tmssngr/z8verilog/readme.md

# Z8 Softcore

The project is about implementing a Zilog Z8 microcontroller in Verilog.

So far it can run the [Tiny computer](https://hc-ddr.hucki.net/wiki/doku.php/tiny) which generates the TV-video output using a timer interrupt:

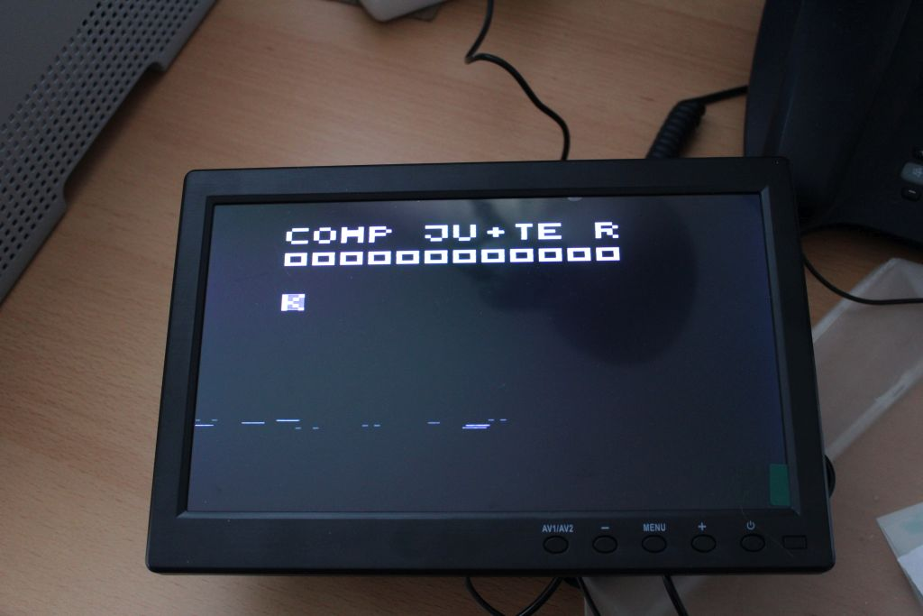
[picture p1: images/IMG_2479s.jpg]
2k Ju+Te-Computer


and its 320x192 pixels extension (here only one 8kB video RAM for monochrome output) with separate video processor:

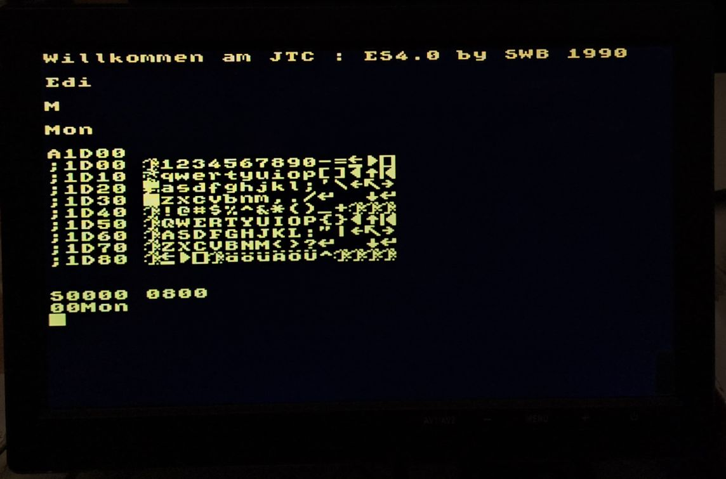
[picture p2: images/jtc6k-es40-hdmi.jpg]
6k ES4.0


on a Tang Tano 9k:
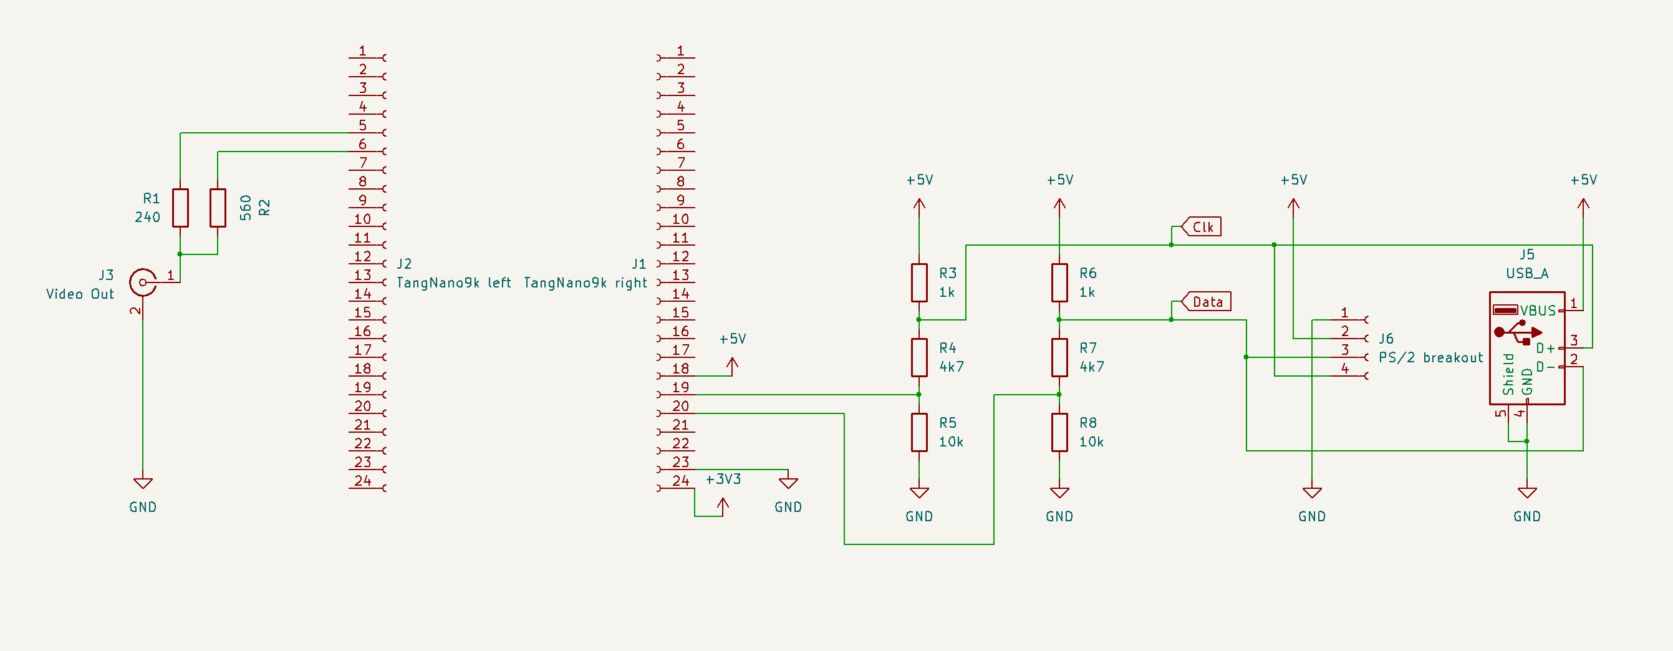
[picture p3: images/schematic-ju+te.png]
Tang Nano 9k


## Notes for Gowin-IDE 1.9.11.03 Education
- in *Project | Configuration*, page *Synthesize* set *Verilog Language* to **System Verilog 2017**
- use right most toolbar buttons to *Synthesize*, *Run Place and Route*, or *Run All*
- Programmer:
  - in *Cable Setting* dialog change *Port* from *USB Debugger A/0/386/null* to **USB Debugger A/1/385/null**
  - *SRAM Program* -> temporary
  - *Embedded Flash Mode* -> permanently

## State of the Z8 Softcore

- [x] implement all operations
  - [x] `nop`
  - [x] carry-flag manipulation operations
  - [x] `srp #IM`
  - [x] single-register ALU operations
    - [x] `xxx R`
    - [x] `xxx IR`
    - [x] `inc r`
  - [x] dual-register ALU operations
    - [x] `xxx r, r`
    - [x] `xxx r, Ir`
    - [x] `xxx R, R`
    - [x] `xxx R, IR`
    - [x] `xxx R, #IM`
    - [x] `xxx IR, #IM`
  - [x] load operations
    - [x] `ld r, #IM`
    - [x] `ld r, R`
    - [x] `ld R, r`
    - [x] `ld r, Ir`
    - [x] `ld Ir, r`
    - [x] `ld R, R`
    - [x] `ld R, IR`
    - [x] `ld IR, R`
    - [x] `ld R, #IM`
    - [x] `ld IR, #IM`
    - [x] `ld r, r(x)`
    - [x] `ld r(x), r`
  - [x] control flow operations
    - [x] `djnz r, RA`
    - [x] `jr cc, RA`
    - [x] `jp cc, DA`
    - [x] `jp IRR`
  - [x] `di`, `ei` (disable/enable interrupt)
  - [x] memory operations
    - [x] `ldc r, Irr`
    - [x] `ldc Irr, r`
    - [x] `ldci Ir, Irr`
    - [x] `ldci Irr, Ir`
    - [x] let `lde`/`ldei` work the same as `ldc`/`ldci`
  - [x] stack operations
    - [x] internal stack
      - [x] `pop R`
      - [x] `pop IR`
      - [x] `push R`
      - [x] `push IR`
      - [x] `call IRR`
      - [x] `call DA`
      - [x] `ret`
      - [x] `iret`
    - [x] external stack
  - [x] illegal instruction handling (stop at that address)
- [ ] port 2
  - [ ] input
  - [x] output
- [ ] port 3
  - [ ] P30-P33 generic input
  - [x] P34-P37 generic output
  - [ ] special counter/serial input/output
- [ ] Timers/Counters
  - [x] basics
  - [ ] special external modes
  - [ ] UART
    - [x] basics
    - [ ] parity handling
- [ ] interrupt handling
  - [x] basics (launching the right interrupt)
  - [ ] handle priorities
