tmssngr/z8verilog/images/jtc-6k.jpg

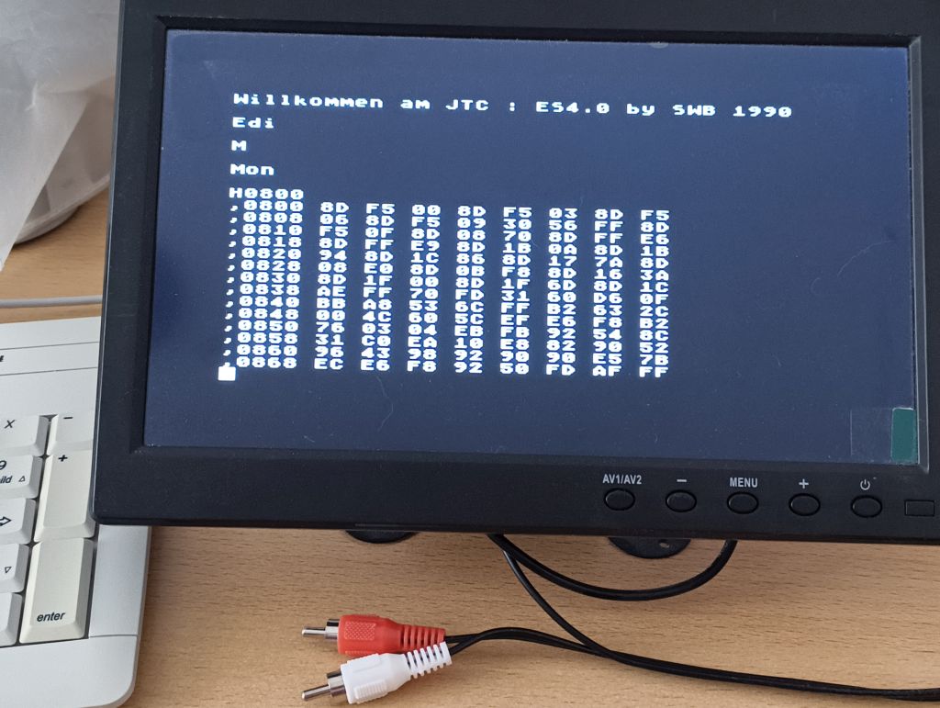
images/jtc-6k.jpg
