tmssngr/z8verilog/images/tang-nano-9k-ju+te.jpg

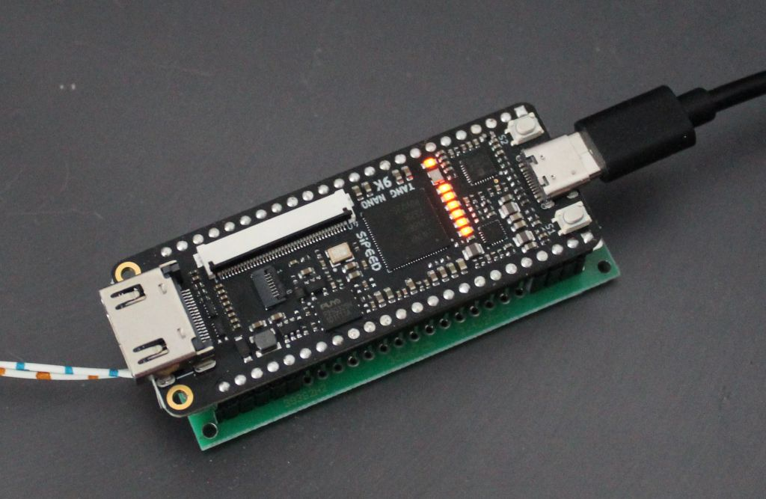
images/tang-nano-9k-ju+te.jpg
