tmssngr/z8verilog/src/Ps2Decoder.v

`include "Ps2Rx.v"
`include "SerialTxDbg.v"

`default_nettype none

// see https://wiki.osdev.org/PS/2_Keyboard
module Ps2Decoder #(
    parameter counterBits = 8,
    parameter minClk = 15,
    parameter maxClk = 25,
    parameter readAt = 5
)
(
    input wire       clk,
    input wire       clkEnable,
    input wire       ps2Clk,
    input wire       ps2Data,
    input wire       reset,
    input wire[3:0]  address,
    output wire[7:0] keybits,
    output wire      error,
    output reg       softReset,
    output wire      debugShift,
    output wire      debugCtrl,
    output wire      debugAlt,
    output wire      debugE0,
    output wire      debugF0
);
    wire [7:0] data;
    wire       dataReady;
    reg        prevDataReady = 0;
    reg        receivedE0 = 0;
    reg        receivedF0 = 0;
    reg [3:0]  column = 0;
    reg [3:0]  columnMask = 0;
    reg [8:0]  activeKey = 0; // {E0 prefix, scan code} of the active ordinary key

    reg  shiftLeft = 0;
    reg  shiftRight = 0;
    reg  ctrlLeft = 0;
    reg  ctrlRight = 0;
    reg  altLeft = 0;
    reg  altRight = 0;
    wire shift = shiftLeft | shiftRight;
    wire ctrl = ctrlLeft | ctrlRight;
    wire alt = altLeft | altRight;

    Ps2Rx #(
        .counterBits(counterBits),
        .minClk(minClk),
        .maxClk(maxClk),
        .readAt(readAt)
    ) rx(
        .clk(clk),
        .clkEnable(clkEnable),
        .ps2Clk(ps2Clk),
        .ps2Data(ps2Data),
        .reset(reset),
        .data(data),
        .dataReady(dataReady),
        .error(error)
    );

    task setColumn;
        input [3:0] col;
        input [1:0] row;
        begin
            column <= col;
            columnMask <= 1 << row;
            activeKey <= {receivedE0, data};
        end
    endtask

    always @(posedge clk) begin
        if (clkEnable) begin
            if (reset) begin
                receivedE0 <= 0;
                receivedF0 <= 0;
                prevDataReady <= 0;
                column <= 0;
                columnMask <= 0;
                activeKey <= 0;
                shiftLeft <= 0;
                shiftRight <= 0;
                ctrlLeft <= 0;
                ctrlRight <= 0;
                altLeft <= 0;
                altRight <= 0;
                softReset <= 0;
            end
            else begin
                if (dataReady != prevDataReady) begin
                    prevDataReady <= dataReady;

                    if (dataReady) begin
                        if (data == 8'hE0) begin
                            receivedE0 <= 1;
                        end
                        else if (data == 8'hF0) begin
                            receivedF0 <= 1;
                        end
                        else begin
                            receivedE0 <= 0;
                            receivedF0 <= 0;
                            case (data)
                            8'h11: begin
                                if (receivedE0) altRight <= ~receivedF0;
                                else            altLeft <= ~receivedF0;
                            end
                            // Extended Shift codes are synthetic, e.g. Print Screen.
                            8'h12: if (~receivedE0) shiftLeft <= ~receivedF0;
                            8'h14: begin
                                if (receivedE0) ctrlRight <= ~receivedF0;
                                else            ctrlLeft <= ~receivedF0;
                            end
                            8'h59: if (~receivedE0) shiftRight <= ~receivedF0;
                            default: begin
                                if (receivedF0) begin
                                    if (activeKey == {receivedE0, data}) begin
                                        column <= 0;
                                        columnMask <= 0;
                                        activeKey <= 0;
                                    end
                                    softReset <= 0;
                                end
                                else if (receivedE0) begin
                                    case (data)
                                    //8'h69: // End
                                    8'h6B: setColumn(4'hD, 2'h2); // cursor left
                                    //8'h6C: // Home
                                    //8'h70: // Ins
                                    8'h71: begin // Del
                                        if (ctrl & alt & ~shift)
                                            softReset <= 1;
                                    end
                                    8'h72: setColumn(4'hE, 2'h0); // cursor down
                                    8'h74: setColumn(4'hF, 2'h1); // cursor right
                                    8'h75: setColumn(4'hE, 2'h2); // cursor up
                                    //8'h7A: // page down
                                    //8'h7D: // page up
                                    endcase
                                end
                                else begin
                                    case (data)
                                    8'h0D: setColumn(4'h1, 2'h2); // tab (left/right)
                                    8'h0E: setColumn(4'h1, 2'h3); // ` (up/down)
                                    8'h15: setColumn(4'h2, 2'h2); // Q
                                    8'h16: setColumn(4'h2, 2'h3); // 1
                                    8'h1A: setColumn(4'h2, 2'h0); // Y
                                    8'h1B: setColumn(4'h3, 2'h1); // S
                                    8'h1C: setColumn(4'h2, 2'h1); // A
                                    8'h1D: setColumn(4'h3, 2'h2); // W
                                    8'h1E: setColumn(4'h3, 2'h3); // 2
                                    8'h21: setColumn(4'h4, 2'h0); // C
                                    8'h22: setColumn(4'h3, 2'h0); // X
                                    8'h23: setColumn(4'h4, 2'h1); // D
                                    8'h24: setColumn(4'h4, 2'h2); // E
                                    8'h25: setColumn(4'h5, 2'h3); // 4
                                    8'h26: setColumn(4'h4, 2'h3); // 3
                                    8'h29: setColumn(4'h1, 2'h0); // Space
                                    8'h2A: setColumn(4'h5, 2'h0); // V
                                    8'h2B: setColumn(4'h5, 2'h1); // F
                                    8'h2C: setColumn(4'h6, 2'h2); // T
                                    8'h2D: setColumn(4'h5, 2'h2); // R
                                    8'h2E: setColumn(4'h6, 2'h3); // 5
                                    8'h31: setColumn(4'h7, 2'h0); // N
                                    8'h32: setColumn(4'h6, 2'h0); // B
                                    8'h33: setColumn(4'h7, 2'h1); // H
                                    8'h34: setColumn(4'h6, 2'h1); // G
                                    8'h35: setColumn(4'h7, 2'h2); // Z
                                    8'h36: setColumn(4'h7, 2'h3); // 6
                                    8'h3A: setColumn(4'h8, 2'h0); // M
                                    8'h3B: setColumn(4'h8, 2'h1); // J
                                    8'h3C: setColumn(4'h8, 2'h2); // U
                                    8'h3D: setColumn(4'h8, 2'h3); // 7
                                    8'h3E: setColumn(4'h9, 2'h3); // 8
                                    8'h41: setColumn(4'h9, 2'h0); // ,
                                    8'h42: setColumn(4'h9, 2'h1); // K
                                    8'h43: setColumn(4'h9, 2'h2); // I
                                    8'h44: setColumn(4'hA, 2'h2); // O
                                    8'h45: setColumn(4'hB, 2'h3); // 0
                                    8'h46: setColumn(4'hA, 2'h3); // 9
                                    8'h49: setColumn(4'hA, 2'h0); // .
                                    8'h4A: setColumn(4'hB, 2'h0); // /
                                    8'h4B: setColumn(4'hA, 2'h1); // L
                                    8'h4C: setColumn(4'hB, 2'h1); // ; (ö*)
                                    8'h4D: setColumn(4'hB, 2'h2); // P
                                    //8'h4E: // -
                                    8'h52: setColumn(4'hC, 2'h1); // ' (ä-)
                                    8'h54: setColumn(4'hC, 2'h2); // [ (ü+)
                                    8'h55: setColumn(4'hC, 2'h2); // =
                                    8'h5A: setColumn(4'hC, 2'h0); // Enter
                                    8'h5B: setColumn(4'hC, 2'h2); // ]
                                    8'h5D: setColumn(4'hC, 2'h1); // \
                                    8'h66: setColumn(4'hC, 2'h3); // backspace

                                    8'h76: setColumn(4'h1, 2'h3); // ESC
                                    endcase
                                end
                            end
                            endcase
                        end
                    end
                end
            end
        end
    end

    assign keybits = (column == address ? {columnMask, 4'b0} : 0)
                   | (shift & (address == 1) ? 8'h20 : 0);
    assign debugShift = shift;
    assign debugCtrl = ctrl;
    assign debugAlt = alt;
    assign debugE0 = receivedE0;
    assign debugF0 = receivedF0;
endmodule

module Ps2DecoderMulti #(
    parameter counterBits = 8,
    parameter minClk = 15,
    parameter maxClk = 25,
    parameter readAt = 5
)
(
    input wire       clk,
    input wire       clkEnable,
    input wire       ps2Clk,
    input wire       ps2Data,
    input wire       reset,
    input wire[3:0]  address,
    output wire[7:0] keybits,
    output wire      error,
    output reg       softReset,
    output wire      debugShift,
    output wire      debugCtrl,
    output wire      debugAlt,
    output wire      debugE0,
    output wire      debugF0
);
    wire [7:0] data;
    wire       dataReady;
    reg        prevDataReady = 0;
    reg        receivedE0 = 0;
    reg        receivedF0 = 0;
    reg [3:0]  column = 0;
    reg [3:0]  columnMask = 0;
    reg [8:0]  activeKey = 0; // {E0 prefix, scan code} of the active ordinary key

    reg  shiftLeft = 0;
    reg  shiftRight = 0;
    reg  ctrlLeft = 0;
    reg  ctrlRight = 0;
    reg  altLeft = 0;
    reg  altRight = 0;
    wire shift = shiftLeft | shiftRight;
    wire ctrl = ctrlLeft | ctrlRight;
    wire alt = altLeft | altRight;

    Ps2Rx #(
        .counterBits(counterBits),
        .minClk(minClk),
        .maxClk(maxClk),
        .readAt(readAt)
    ) rx(
        .clk(clk),
        .clkEnable(clkEnable),
        .ps2Clk(ps2Clk),
        .ps2Data(ps2Data),
        .reset(reset),
        .data(data),
        .dataReady(dataReady),
        .error(error)
    );

    task setColumn;
        input [3:0] col;
        input [1:0] row;
        begin
            column <= col;
            columnMask <= 1 << row;
            activeKey <= {receivedE0, data};
        end
    endtask

    always @(posedge clk) begin
        if (clkEnable) begin
            if (reset) begin
                receivedE0 <= 0;
                receivedF0 <= 0;
                prevDataReady <= 0;
                column <= 0;
                columnMask <= 0;
                activeKey <= 0;
                shiftLeft <= 0;
                shiftRight <= 0;
                ctrlLeft <= 0;
                ctrlRight <= 0;
                altLeft <= 0;
                altRight <= 0;
                softReset <= 0;
            end
            else begin
                if (dataReady != prevDataReady) begin
                    prevDataReady <= dataReady;

                    if (dataReady) begin
                        if (data == 8'hE0) begin
                            receivedE0 <= 1;
                        end
                        else if (data == 8'hF0) begin
                            receivedF0 <= 1;
                        end
                        else begin
                            receivedE0 <= 0;
                            receivedF0 <= 0;
                            case (data)
                            8'h11: begin
                                if (receivedE0) altRight <= ~receivedF0;
                                else            altLeft <= ~receivedF0;
                            end
                            // Extended Shift codes are synthetic, e.g. Print Screen.
                            8'h12: if (~receivedE0) shiftLeft <= ~receivedF0;
                            8'h14: begin
                                if (receivedE0) ctrlRight <= ~receivedF0;
                                else            ctrlLeft <= ~receivedF0;
                            end
                            8'h59: if (~receivedE0) shiftRight <= ~receivedF0;
                            /*
                              | 0 | 1 | 2 | 3 | 4 | 5 | 6 | 7 | 8 | 9 | A | B | C | D | E | F |
                            --+---+---+---+---+---+---+---+---+---+---+---+---+---+---+---+---+
                             3|   | 1 | 2 | 3 | 4 | 5 | 6 | 7 | 8 | 9 | 0 | < | > |BSp|Ins|CLS|
                            --+---+---+---+---+---+---+---+---+---+---+---+---+---+---+---+---+
                             2|Alt| Q | W | E | R | T | Z | U | I | O | P | - | = |Del| Up|Hom|
                            --+---+---+---+---+---+---+---+---+---+---+---+---+---+---+---+---+
                             1|Ctr| A | S | D | F | G | H | J | K | L | ; | + | * |Lft|LTp|Rgt|
                            --+---+---+---+---+---+---+---+---+---+---+---+---+---+---+---+---+
                             0|Shf| Y | X | C | V | B | N | M | , | . | / |Ret|Spc|Spc|Dwn|Ret|
                            --+---+---+---+---+---+---+---+---+---+---+---+---+---+---+---+---+
                            */
                            default: begin
                                if (receivedF0) begin
                                    if (activeKey == {receivedE0, data}) begin
                                        column <= 0;
                                        columnMask <= 0;
                                        activeKey <= 0;
                                    end
                                    softReset <= 0;
                                end
                                else if (receivedE0) begin
                                    case (data)
                                    //8'h69: // End
                                    8'h6B: setColumn(4'hD, 2'h1); // cursor left
                                    8'h6C: setColumn(4'hF, 2'h2); // Home
                                    8'h70: setColumn(4'hE, 2'h3); // Ins
                                    8'h71: begin // Del
                                        if (ctrl & alt & ~shift)
                                            softReset <= 1;
                                        else
                                            setColumn(4'hD, 2'h2); 
                                    end
                                    8'h72: setColumn(4'hE, 2'h0); // cursor down
                                    8'h74: setColumn(4'hF, 2'h1); // cursor right
                                    8'h75: setColumn(4'hE, 2'h2); // cursor up
                                    //8'h7A: // page down
                                    8'h7D: setColumn(4'hE, 2'h1); // page up (top-left)
                                    endcase
                                end
                                else begin
                                    case (data)
                                    //8'h0D: // tab
                                    //8'h0E: // `
                                    8'h15: setColumn(4'h1, 2'h2); // Q
                                    8'h16: setColumn(4'h1, 2'h3); // 1
                                    8'h1A: setColumn(4'h1, 2'h0); // Y
                                    8'h1B: setColumn(4'h2, 2'h1); // S
                                    8'h1C: setColumn(4'h1, 2'h1); // A
                                    8'h1D: setColumn(4'h2, 2'h2); // W
                                    8'h1E: setColumn(4'h2, 2'h3); // 2
                                    8'h21: setColumn(4'h3, 2'h0); // C
                                    8'h22: setColumn(4'h2, 2'h0); // X
                                    8'h23: setColumn(4'h3, 2'h1); // D
                                    8'h24: setColumn(4'h3, 2'h2); // E
                                    8'h25: setColumn(4'h4, 2'h3); // 4
                                    8'h26: setColumn(4'h3, 2'h3); // 3
                                    8'h29: setColumn(4'hC, 2'h0); // Space
                                    8'h2A: setColumn(4'h4, 2'h0); // V
                                    8'h2B: setColumn(4'h4, 2'h1); // F
                                    8'h2C: setColumn(4'h5, 2'h2); // T
                                    8'h2D: setColumn(4'h4, 2'h2); // R
                                    8'h2E: setColumn(4'h5, 2'h3); // 5
                                    8'h31: setColumn(4'h6, 2'h0); // N
                                    8'h32: setColumn(4'h5, 2'h0); // B
                                    8'h33: setColumn(4'h6, 2'h1); // H
                                    8'h34: setColumn(4'h5, 2'h1); // G
                                    8'h35: setColumn(4'h6, 2'h2); // Z
                                    8'h36: setColumn(4'h6, 2'h3); // 6
                                    8'h3A: setColumn(4'h7, 2'h0); // M
                                    8'h3B: setColumn(4'h7, 2'h1); // J
                                    8'h3C: setColumn(4'h7, 2'h2); // U
                                    8'h3D: setColumn(4'h7, 2'h3); // 7
                                    8'h3E: setColumn(4'h8, 2'h3); // 8
                                    8'h41: setColumn(4'h8, 2'h0); // ,
                                    8'h42: setColumn(4'h8, 2'h1); // K
                                    8'h43: setColumn(4'h8, 2'h2); // I
                                    8'h44: setColumn(4'h9, 2'h2); // O
                                    8'h45: setColumn(4'hA, 2'h3); // 0
                                    8'h46: setColumn(4'h9, 2'h3); // 9
                                    8'h49: setColumn(4'h9, 2'h0); // .
                                    8'h4A: setColumn(4'hA, 2'h0); // /
                                    8'h4B: setColumn(4'h9, 2'h1); // L
                                    8'h4C: setColumn(4'hA, 2'h1); // ; (ö)
                                    8'h4D: setColumn(4'hA, 2'h2); // P
                                    8'h4E: setColumn(4'hB, 2'h3); // - (<)
                                    8'h52: setColumn(4'hB, 2'h1); // ' (ä+)
                                    8'h54: setColumn(4'hB, 2'h2); // [ (ü-)
                                    8'h55: setColumn(4'hC, 2'h3); // = (>)
                                    8'h5A: setColumn(4'hB, 2'h0); // Enter
                                    8'h5B: setColumn(4'hC, 2'h2); // ] (+=)
                                    8'h5D: setColumn(4'hC, 2'h1); // \ (#*)
                                    8'h66: setColumn(4'hD, 2'h3); // backspace

                                    8'h76: setColumn(4'hF, 2'h3); // ESC (CLS)
                                    endcase
                                end
                            end
                            endcase
                        end
                    end
                end
            end
        end
    end

    assign keybits = (column == address ? {columnMask, 4'b0} : 0)
                   | (shift & (address == 0) ? 8'h10 : 0)
                   | (ctrl & (address == 0) ? 8'h20 : 0)
                   | (alt & (address == 0) ? 8'h40 : 0);
    assign debugShift = shift;
    assign debugCtrl = ctrl;
    assign debugAlt = alt;
    assign debugE0 = receivedE0;
    assign debugF0 = receivedF0;
endmodule
