tmssngr/z8verilog/(commit log)

2024-01-25 connect the leds to port2
2024-01-25 specify 'wire' for input/output
2024-01-25 Alu.v: fixing error "Mixed blocking and non-blocking assignments on 'out' is not supported"
    [Alu.v]
2024-01-25 Processor: comment unused reset
    [SoC.v]
2024-01-25 fix size of operands
    [Alu.v, SoC.v]
2024-01-25 replace case with casez
    [SoC.v]
2024-01-26 Alu: fix warning about latch
    [Alu.v]
2024-01-27 top: map port2 (8 bits) to inverted 6 leds
2024-01-27 simplify device program
2024-01-27 replace tabs with spaces
    [Alu.v, SoC.v]
2024-02-01 fix ld r, R
    [SoC.v]
2024-02-02 assembly.vh: sort order of ld-tasks by op-code
2024-02-03 SoC.v: reset temp registers only if bench mode
    [SoC.v]
2024-02-11 fix different timing for 'swap'
    [SoC.v]
2024-02-12 interrupt handling (ignoring priorities)
2024-02-15 try to solve the error "net irq[5] is driven from multiple places"
    reported by Gowin IDE
    the same net must not be set by different always @ blocks (even with different edge)
    [SoC.v]
2024-02-17 iret: strengthened flag handling
    [SoC.v]
2024-02-17 don't log (matching) cycle count, but if unmatched, fail
    [SoC.v]
2024-03-30 tangnano9k.cst: new board layout using different/swapped pins
2024-04-07 add schematic to readme.md
2024-04-13 avoid flickering by loading video data only if an ISR is running
    (impossible on real Z8 hardware)
    [Processor.v, SoC.v]
2024-04-14 set LEDs in top.v, not SoC.v
2024-04-14 Ps2Decoder: rework key handling, especially for shift
    [Ps2Decoder.v]
2024-04-21 remove testcases/device
2024-04-27 Ps2Decoder: fix Del handling
    [Ps2Decoder.v]
2024-05-01 fix order of declarations
    YoSys otherwise complains
    [Memory.v, Ps2Rx.v, SoC_tb.v, SoC_tiny_tb.v]
2024-05-02 Alu: bug fix for 'da' after 0x96+0x96
    [Alu.v]
2024-05-14 add support for SIO (RX, TX; no parity handling yet)
    settings SIO should reload T0
    setting P3M[7] should reset SIO states
    [Processor.v, SoC.v, SoC_tb.v, SoC_tiny.v]
2026-06-03 top: fix case of debouncer include
2026-06-03 Processor: move reset logic up and do the other things only if not reset
    [Processor.v]
2026-08-05 SoC_es40.v: fix ramE0Enable comparison
    [SoC_es40.v]
2026-11-01 Processor: disable global interrupts on reset
2026-11-01 Processor: gate UART reception with serial mode enable
2026-11-01 Ps2Decoder: track left and right Ctrl and Alt independently
2026-11-01 top_es40: synchronize UART RX in the SoC clock domain
    Synchronize serialIn through two 8 MHz flip-flops and run its input filter on that same clock. This removes the direct 27 MHz filter-output crossing into the processor.
    Validated 4800-baud receive/echo through the top-level input path with both 5852619d and 4d823bca SoCs. The original designs also pass ideal RTL simulation, so confirming the placement-sensitive hardware failure still requires an FPGA run.
